rolandblok/GalvoExpress/README.md

# GalvoExpress
Driver and electronics to drive A-express galvo with mircrocontroller

## Kicad
V1.1 : 
- fix transistor for laser : this was wrong
- DAC was completely wrong
