rolandblok/GalvoExpress/kicad/galvoexpress/galvoexpress.kicad_pcb

## KiCad design kicad/galvoexpress/galvoexpress.kicad_pcb (2026-02-06)

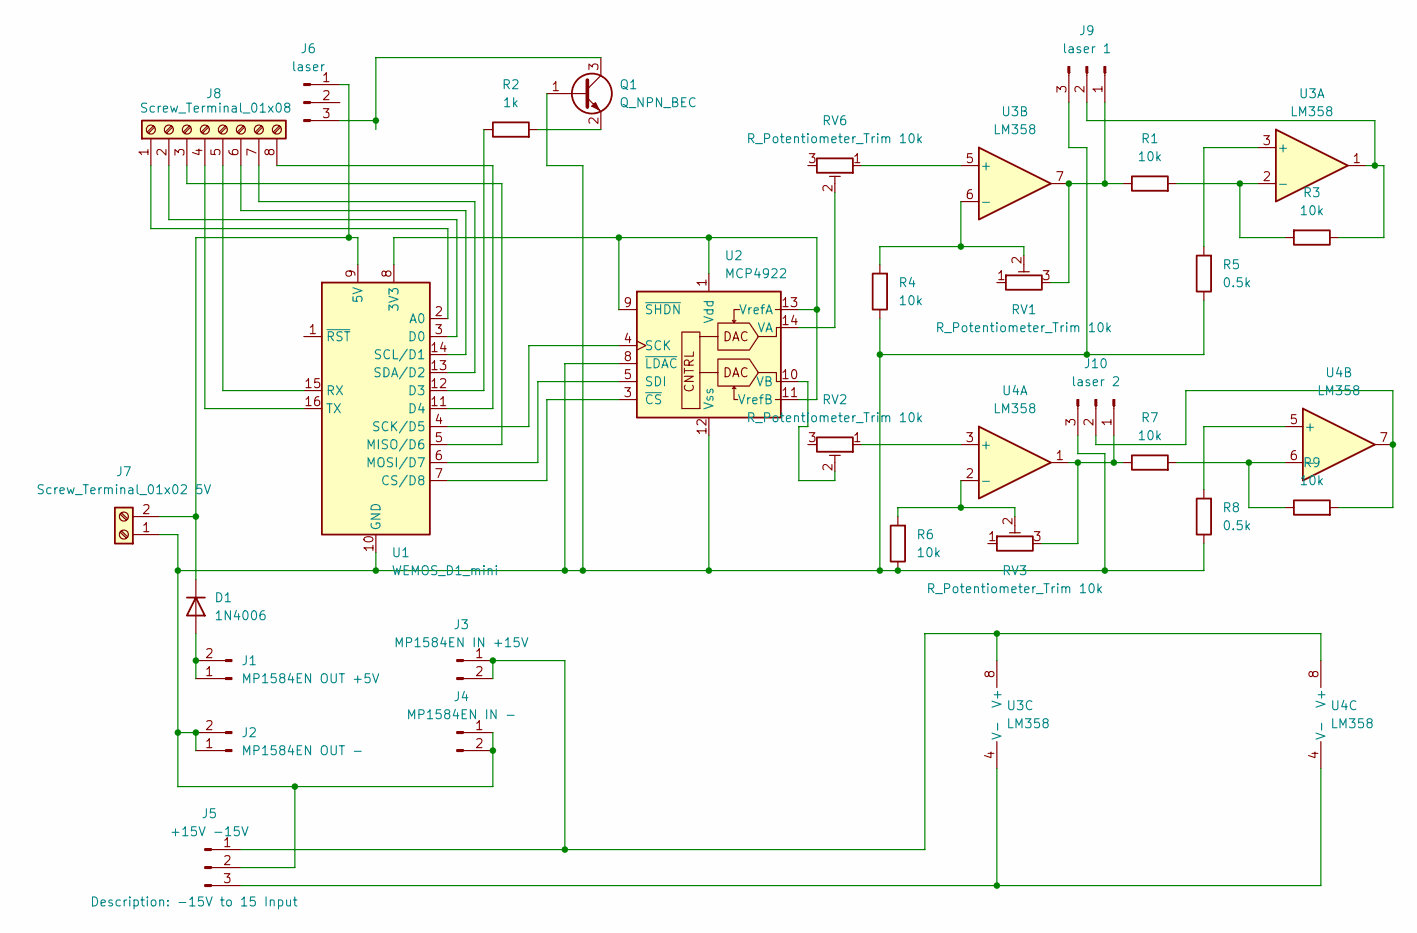
[picture p1: schematic galvoexpress.kicad_sch]

Parts:
D1: 1N4006; D_DO-41_SOD81_P10.16mm_Horizontal
J1: MP1584EN OUT +5V; PinHeader_1x02_P2.54mm_Vertical
J2: MP1584EN OUT -; PinHeader_1x02_P2.54mm_Vertical
J3: MP1584EN IN +15V; PinHeader_1x02_P2.54mm_Vertical
J4: MP1584EN IN -; PinHeader_1x02_P2.54mm_Vertical
J5: +15V -15V; JST_XH_S3B-XH-A-1_1x03_P2.50mm_Horizontal
J6: laser; PinHeader_1x03_P2.54mm_Vertical
J7: Screw_Terminal_01x02 5V; TerminalBlock_MetzConnect_Type059_RT06302HBWC_1x02_P3.50mm_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
J8: Screw_Terminal_01x08; TerminalBlock_Phoenix_MPT-0,5-8-2.54_1x08_P2.54mm_Horizontal
J9: laser 1; JST_XH_S3B-XH-A-1_1x03_P2.50mm_Horizontal
J10: laser 2; JST_XH_S3B-XH-A-1_1x03_P2.50mm_Horizontal
Q1: Q_NPN_BEC; TO-92L_Inline
R1, R3, R4, R6, R7, R9: 10k; R_Axial_DIN0309_L9.0mm_D3.2mm_P12.70mm_Horizontal
R2: 1k; R_Axial_DIN0309_L9.0mm_D3.2mm_P12.70mm_Horizontal
R5, R8: 0.5k; R_Axial_DIN0309_L9.0mm_D3.2mm_P12.70mm_Horizontal
RV1, RV2, RV3, RV6: R_Potentiometer_Trim 10k; Potentiometer_Bourns_3296W_Vertical
U1: WEMOS_D1_mini; WEMOS_D1_mini_light
U2: MCP4922; DIP-14_W7.62mm
U3, U4: LM358; DIP-8_W7.62mm

Connections:
unnamed: D1.2 (A), J1.1, J1.2
unnamed: D1.1 (K), J6.1, J7.2, U1.9 (5V)
unnamed: J3.1, J3.2, J5.1, U3.8 (V+), U4.8 (V+)
unnamed: J5.3, U3.4 (V-), U4.4 (V-)
unnamed: J6.3, Q1.3 (C)
unnamed: J8.1, U1.2 (A0)
unnamed: J8.2, U1.3 (D0)
unnamed: J8.3, U1.5 (MISO/D6)
unnamed: J8.4, U1.16 (TX)
unnamed: J8.5, U1.15 (RX)
unnamed: J8.6, U1.14 (SCL/D1)
unnamed: J8.7, U1.13 (SDA/D2)
unnamed: J8.8, U1.11 (D4)
unnamed: J9.1, R1.1, RV1.3, U3.7
unnamed: J9.2, R3.1, U3.1
unnamed: J10.1, R7.1, RV3.3, U4.1
unnamed: J10.2, R9.2, U4.7
unnamed: J2.1, J2.2, J4.1, J4.2, J5.2, J7.1, J9.3, J10.3, Q1.1 (B), R4.1, R5.1, R6.1, R8.1, U1.10 (GND), U2.8 (~LDAC), U2.12 (Vss)
unnamed: Q1.2 (E), R2.2
unnamed: U1.8 (3V3), U2.1 (Vdd), U2.9 (~SHDN), U2.11 (VrefB), U2.13 (VrefA)
unnamed: U1.7 (CS/D8), U2.3 (~CS)
unnamed: R2.1, U1.12 (D3)
unnamed: U1.6 (MOSI/D7), U2.5 (SDI)
unnamed: U1.4 (SCK/D5), U2.4 (SCK)
unnamed: RV6.2, U2.14 (VA)
unnamed: RV2.2, U2.10 (VB)
unnamed: R5.2, U3.3 (+)
unnamed: R1.2, R3.2, U3.2 (-)
unnamed: RV6.1, U3.5 (+)
unnamed: R4.2, RV1.2, U3.6 (-)
unnamed: RV2.1, U4.3 (+)
unnamed: R6.2, RV3.2, U4.2 (-)
unnamed: R8.2, U4.5 (+)
unnamed: R7.2, R9.1, U4.6 (-)

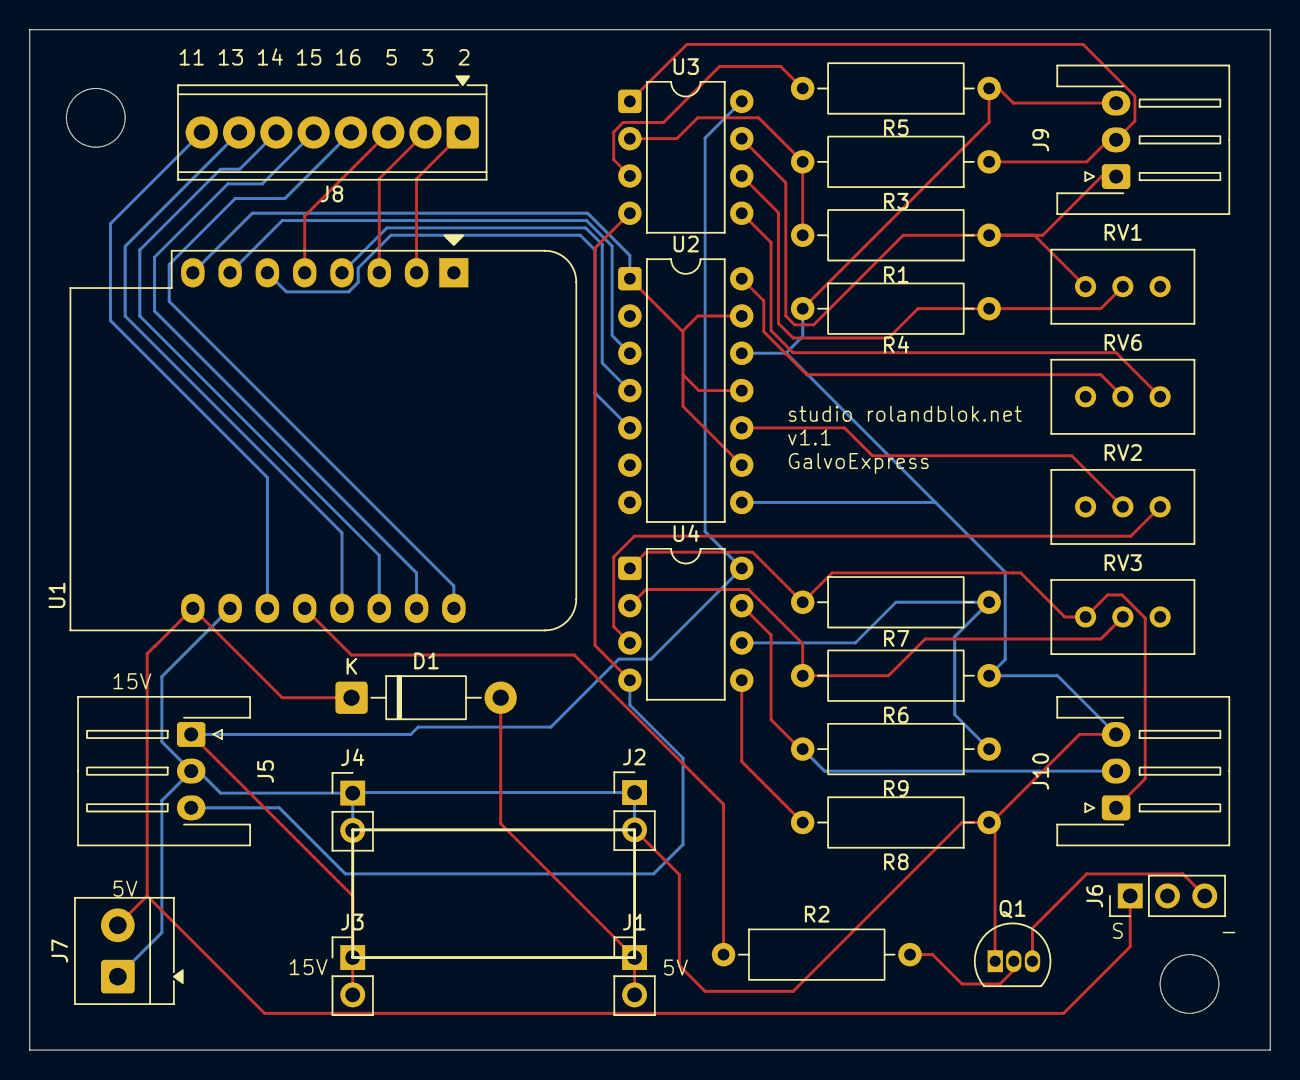
[picture p2: board galvoexpress.kicad_pcb from above]

Board: 2 copper layers, 84.5 x 69.5 mm, 29 parts (0 on the bottom side), 34 nets.
