rolandblok/GalvoExpress/kicad/v1_bug_dac_PCB.png

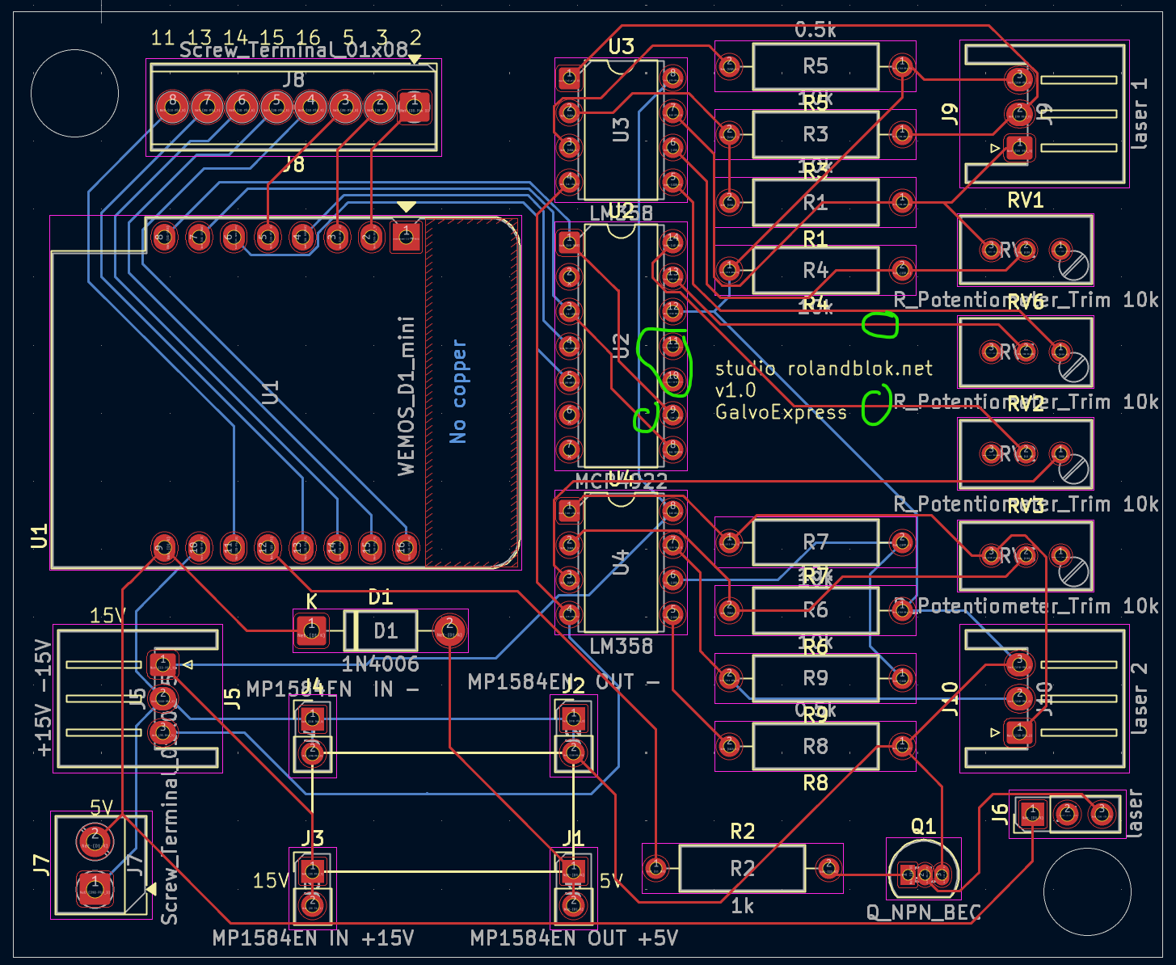
kicad/v1_bug_dac_PCB.png
