rolandblok/GalvoExpress/kicad/v1_bug_dac_schema.png

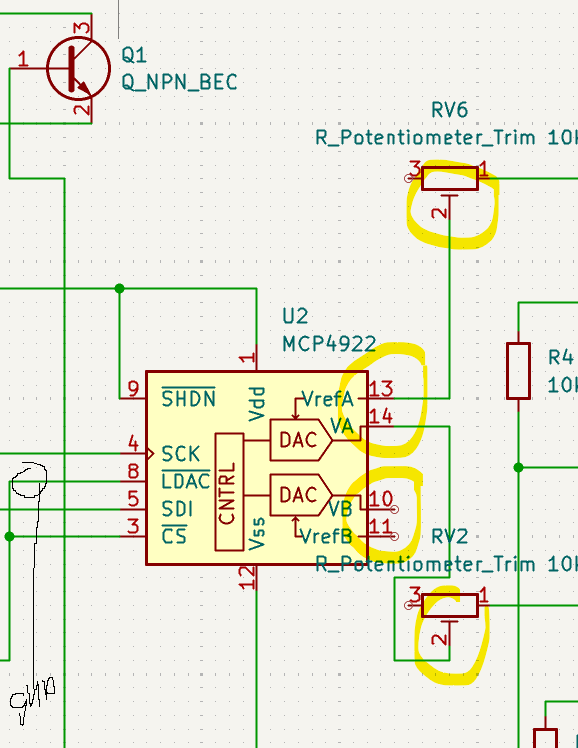
kicad/v1_bug_dac_schema.png
