rolandblok/GalvoExpress/laser_galvo_A_drivert/patern.cpp

#include "patern.hpp"
#include "mytypes.hpp"
#include "mystore.hpp"
#include <math.h>
#include <vector>
#include <Arduino.h>

#include <vector>
using namespace std;

#define MAX 4095

int patern_index = 0;
vector<patern_point> patern_points;

void patern_setup()
{
    if (!mystore_load_pattern(patern_points)) {
        // If loading fails, create a default pattern
        patern_create_circle();
    }
    Serial.println("# Loaded pattern, length: " + String(patern_points.size()));
}

void patern_add_line(int x1, int y1, int x2, int y2, bool laser_on, float step_distance)
{
    int dx = x2 - x1;
    int dy = y2 - y1;
    float distance = sqrt( (dx*dx) + (dy*dy) );
    
    int NO_STEPS = max(1, (int)ceil(distance / step_distance));
      
    for (int i = 1; i <= NO_STEPS; i++) {
        float t = (float)i / NO_STEPS;  // 0.0 to 1.0
        int x = x1 + (int)(dx * t);
        int y = y1 + (int)(dy * t);
        patern_upload_step(x, y, laser_on);
    }

}

void patern_add_square(int xmin, int xmax, int ymin, int ymax, bool laser_on = true)  
{
    // xmin, ymin
    patern_add_line(xmin, ymin, xmax, ymin, laser_on);
    patern_add_line(xmax, ymin, xmax, ymax, laser_on);
    patern_add_line(xmax, ymax, xmin, ymax, laser_on);
    patern_add_line(xmin, ymax, xmin, ymin, laser_on);
}
void patern_create_square(int xmin, int xmax, int ymin, int ymax, bool laser_on)
{
    patern_upload_start();
    patern_add_square(xmin, xmax, ymin, ymax, laser_on);
    patern_upload_stop();
}

void patern_double_square(bool one_on, bool two_on)
{
    patern_upload_start();

    patern_add_square(0, 0.75*MAX, 0, 0.75*MAX, one_on);
    // patern_upload_step(0.25*MAX, 0.25*MAX, false);
    patern_add_line(0, 0, 0.25*MAX, 0.25*MAX, false); // laser off between squares

    patern_add_square(0.25*MAX, MAX, 0.25*MAX, MAX, two_on);
    // patern_upload_step(0, 0, false);
    patern_add_line(0.25*MAX, 0.25*MAX, 0, 0, false); // laser off between squares
    
    patern_upload_stop();
}

void patern_create_circle()
{
    patern_upload_start();
    const int steps = 100;
    for (int i = 0; i < steps; i++) {
        float angle = (2.0f * 3.14159265f * i) / steps;
        int x = (int)( (MAX / 2) + (MAX / 2) * cos(angle) );
        int y = (int)( (MAX / 2) + (MAX / 2) * sin(angle) );
        patern_upload_step(x, y, true);
    }
    patern_upload_stop();
}

void patern_create_point(int x, int y, bool laser_on)
{
    patern_upload_start();
    patern_upload_step(x, y, laser_on);
    patern_upload_stop();
}

volatile bool patern_saving = false;

void patern_get_next_step(volatile int & x, volatile int & y, volatile bool &laser_on)
{
    if (patern_saving) {
        x = 0;
        y = 0;
        laser_on = true;
        return ;
    }

    // mystore_load_next_patern_point(x, y, laser_on);
    if (patern_points.size() == 0)
    {
        x = 0;
        y = 0;
        laser_on = true;
        return;
    }

    x = patern_points[patern_index].x;
    y = patern_points[patern_index].y;
    laser_on = patern_points[patern_index].laser_on;
    patern_index++;
    if (patern_index >= patern_points.size()) patern_index = 0;
    return;
}


void patern_upload_start()
{
    patern_saving = true;
    patern_points.clear();
}

void patern_upload_step(int x, int y, bool laser_on)
{
    patern_points.push_back({x, y, laser_on});
}
void patern_upload_stop()
{
    Serial.println("# Uploading patern stop, total points: " + String(patern_points.size()));
    delay(100);

    patern_index = 0;

    mystore_save_pattern(patern_points);

    delay(100);
    patern_saving = false;
}

int patern_get_length()
{
    return patern_points.size();
}

void patern_serial_log_current_patern()
{
    Serial.print("# Current patern, length: ");
    Serial.println(patern_points.size());
    for (size_t i = 0; i < patern_points.size(); i++)
    {
        Serial.print("# ");
        Serial.print(i);
        Serial.print(": x=");
        Serial.print(patern_points[i].x);
        Serial.print(", y=");
        Serial.print(patern_points[i].y);
        Serial.print(", laser_on=");
        Serial.println(patern_points[i].laser_on ? "true" : "false");
    }
}
