rolandblok/GalvoExpress/(commit log)

2025-12-24 start on patern to arduino
2026-01-04 start kicad
    [galvoexpress.kicad_pcb, galvoexpress.kicad_sch]
2026-01-04 hele schema
    [galvoexpress.kicad_sch]
2026-01-06 delay for laser andor position
2026-01-16 kicad WIP
    [galvoexpress.kicad_pcb, galvoexpress.kicad_sch]
2026-01-23 kicad v1.0
    [galvoexpress-B_Cu.gbl, galvoexpress-B_Mask.gbs, galvoexpress-B_Paste.gbp, galvoexpress-B_Silkscreen.gbo, galvoexpress-Edge_Cuts.gm1, galvoexpress-F_Cu.gtl, galvoexpress-F_Mask.gts, galvoexpress-F_Paste.gtp]
2026-02-06 kicad repairs
    [galvoexpress.kicad_pcb, galvoexpress.kicad_sch]
2026-02-06 bug report PCB
